dongxuanhien/Project_Doan1/(list of files, drawings)

Other design files:
Circuit/finalPCB.pcbdoc
Circuit/Sheet1.schdoc
